isc-fs/IFS09-CE-SENSORHUB/SensorHub_Schematic_v2_051126.pdf

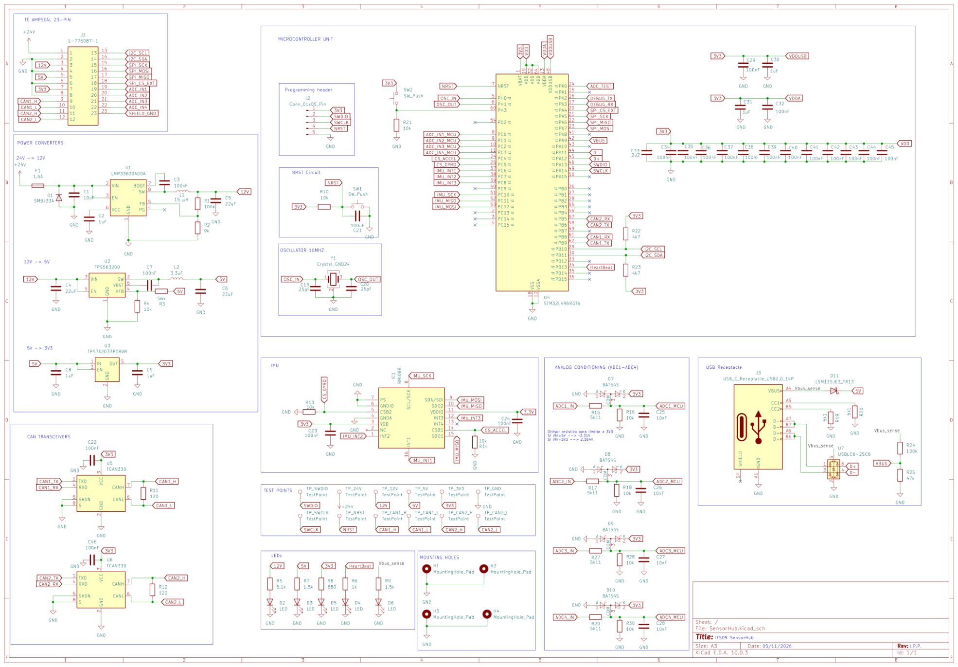
[picture p3: page 1]
