isc-fs/IFS09-CE-SENSORHUB/SensorHub_Schematic_v1_121026.pdf

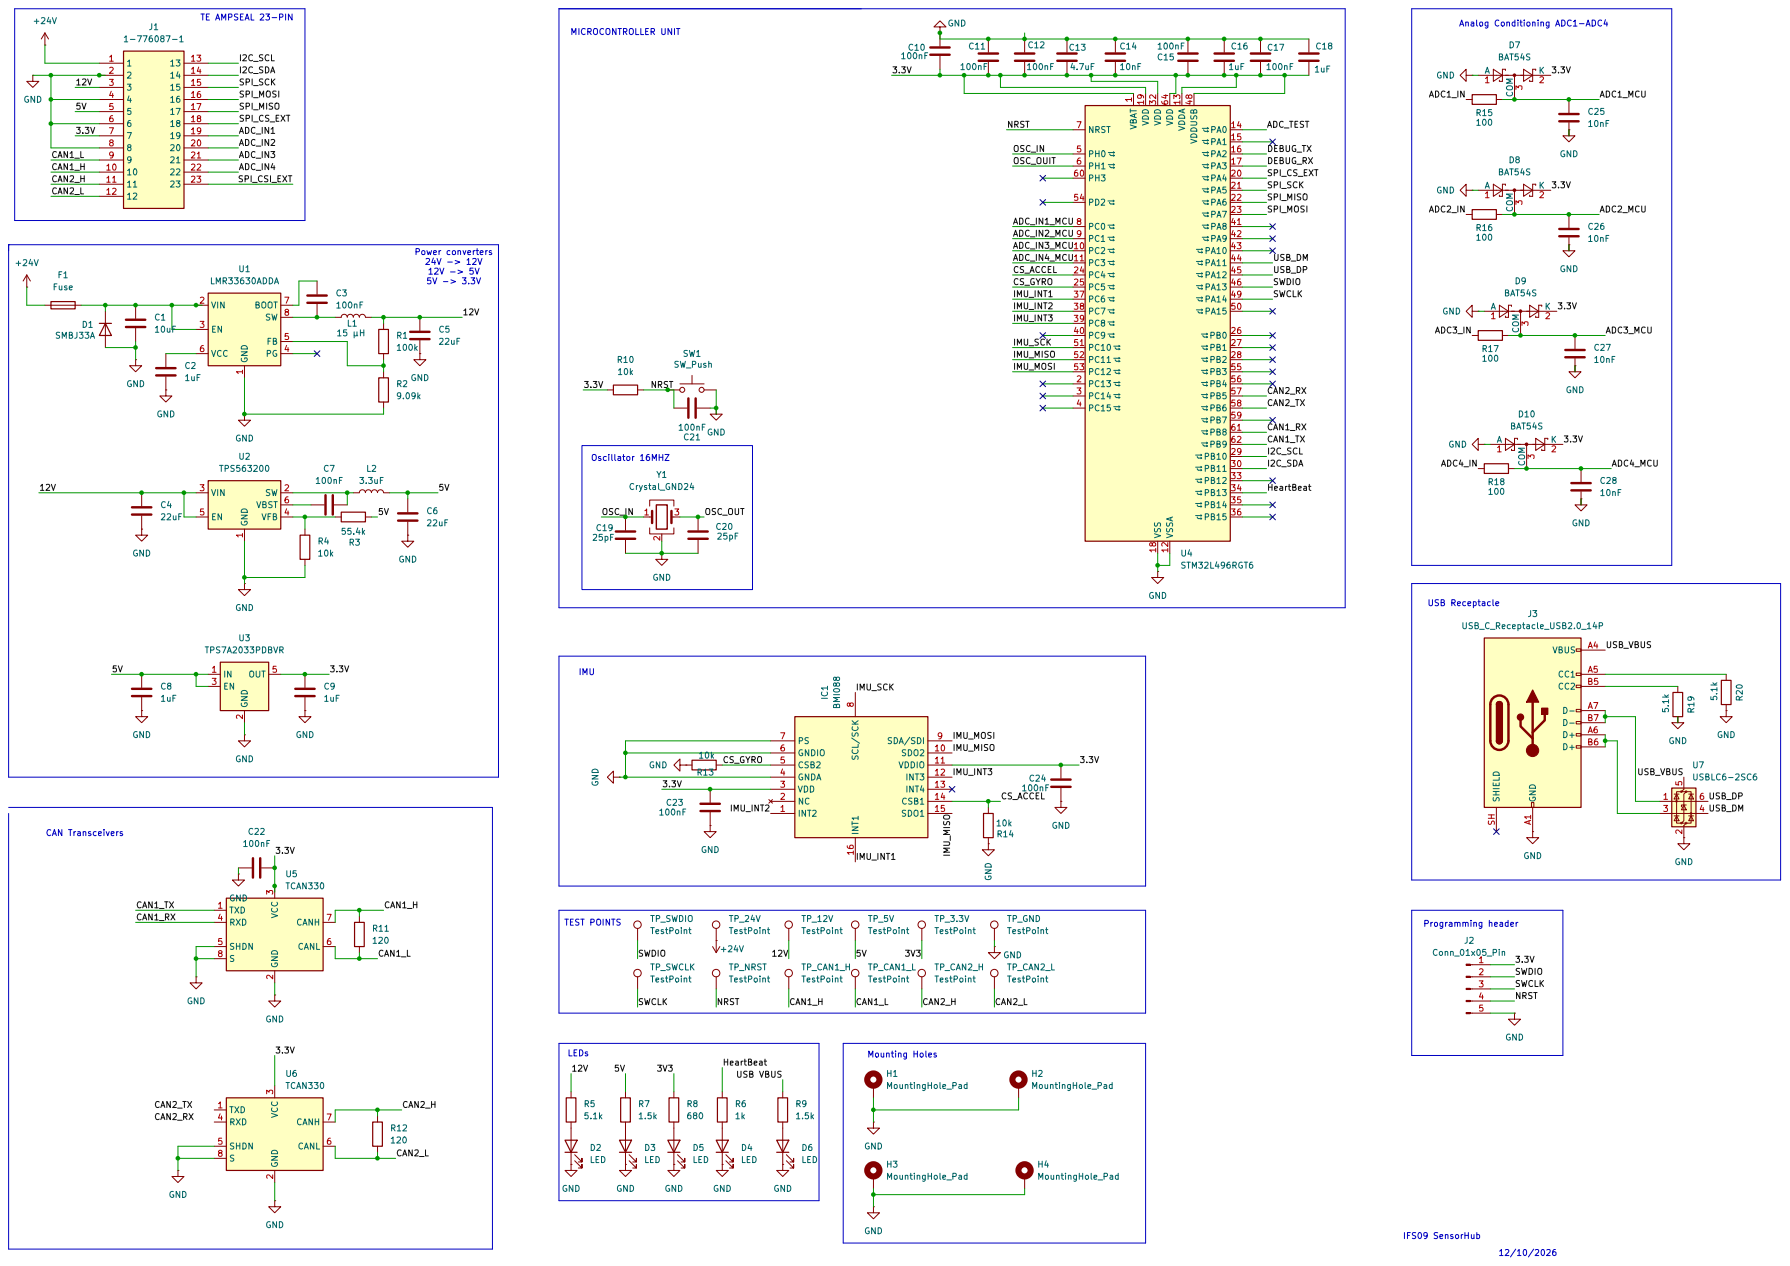
[picture p4: page 1]
