isc-fs/IFS09-CE-SENSORHUB/(commit log)

2026-10-12 12 Oct 2026 Schematic (SensorHub v1)
    [SensorHub.kicad_pcb, SensorHub.kicad_sch]
2026-10-25 Arreglo conexion CAN2
    [SensorHub.kicad_sch]
2026-11-05 5 Nov 2026 Schematic v2
    [SensorHub.kicad_sch]
